anteo/zxevo.pentevo/cfgs/standalone_base_trdemu/trunk/README

make.sh uses avr/baseconf/trunk and fpga/base_trdemu/trunk from the repository.
FPGA_PATH, AVR_PATH and MHMT_BIN can be overridden through the environment.

On macOS, make.sh builds the host utilities using make before running the
original build sequence:

./cfgs/standalone_base_trdemu/trunk/make.sh

Для wsl:
Пересобрать mhmt и make_fw.

Для Windows:
скачать архив отсюда https://blog.zakkemble.net/avr-gcc-builds/
и распаковать.
В файле winbuild.bat исправить путь до 
папки bin из выше скаченного архива.
winbuild.bat не собирает исходники fpga, т.е. они должны быть
предварительно собраны.
