anteo/zxevo.pentevo/kicad/rev_d+/Sheet2.kicad_sch

## KiCad design kicad/rev_d+/Sheet2.kicad_sch (2026-09-26)

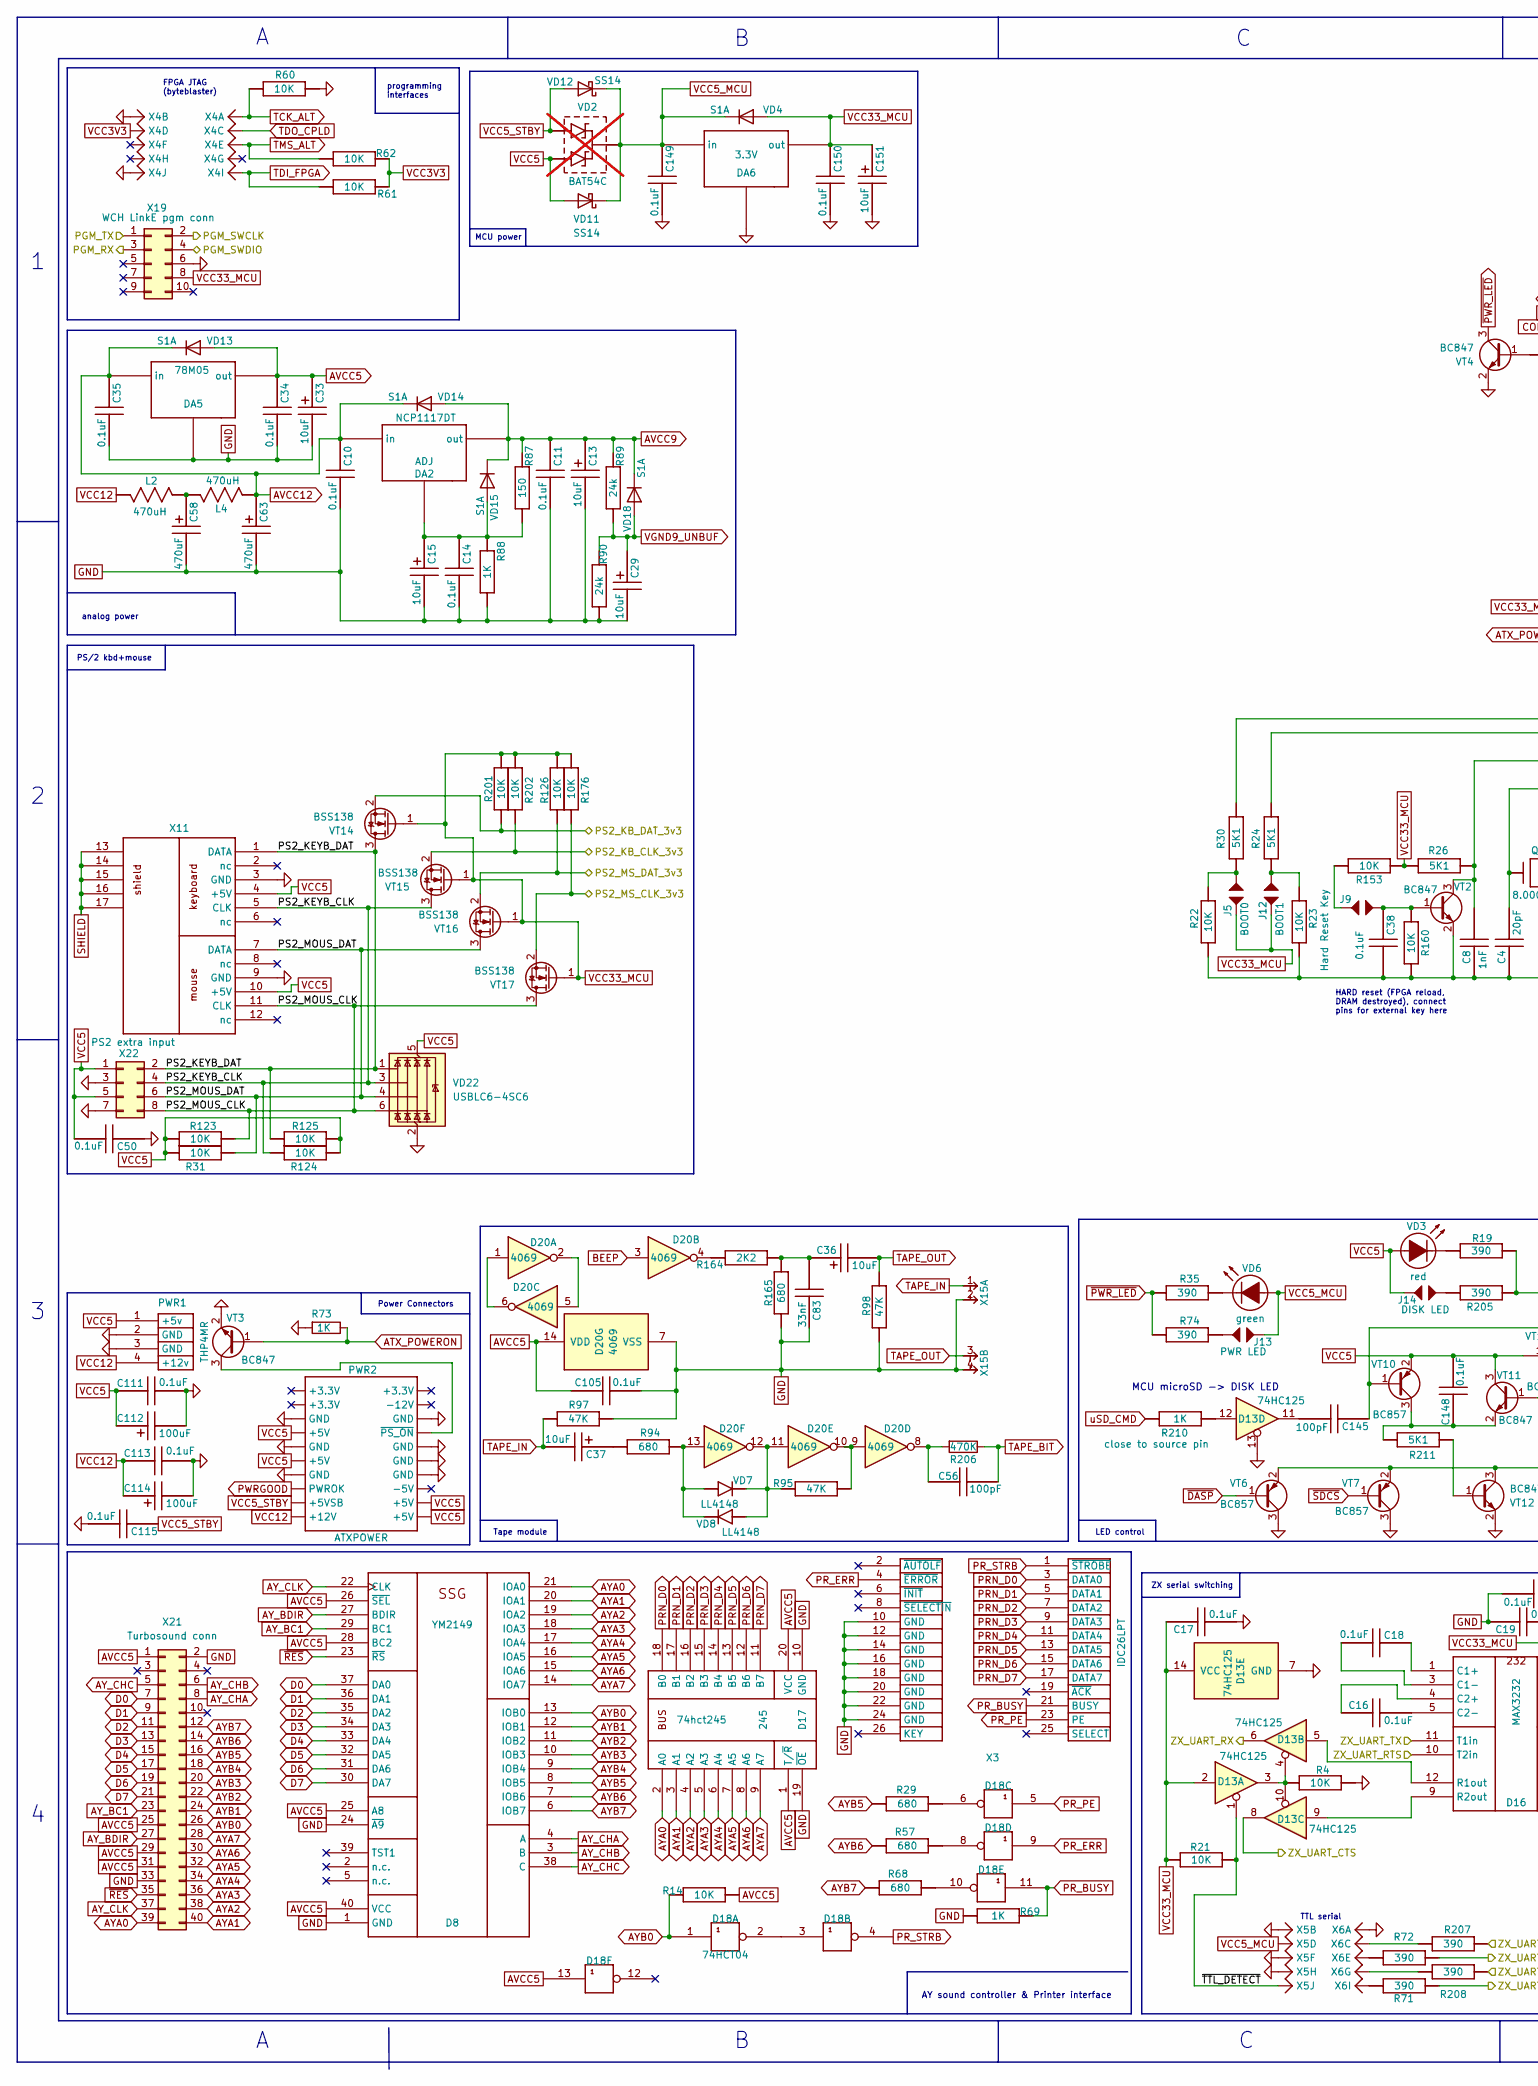
[picture p14: schematic Sheet2.kicad_sch, part in row 1, column 1]

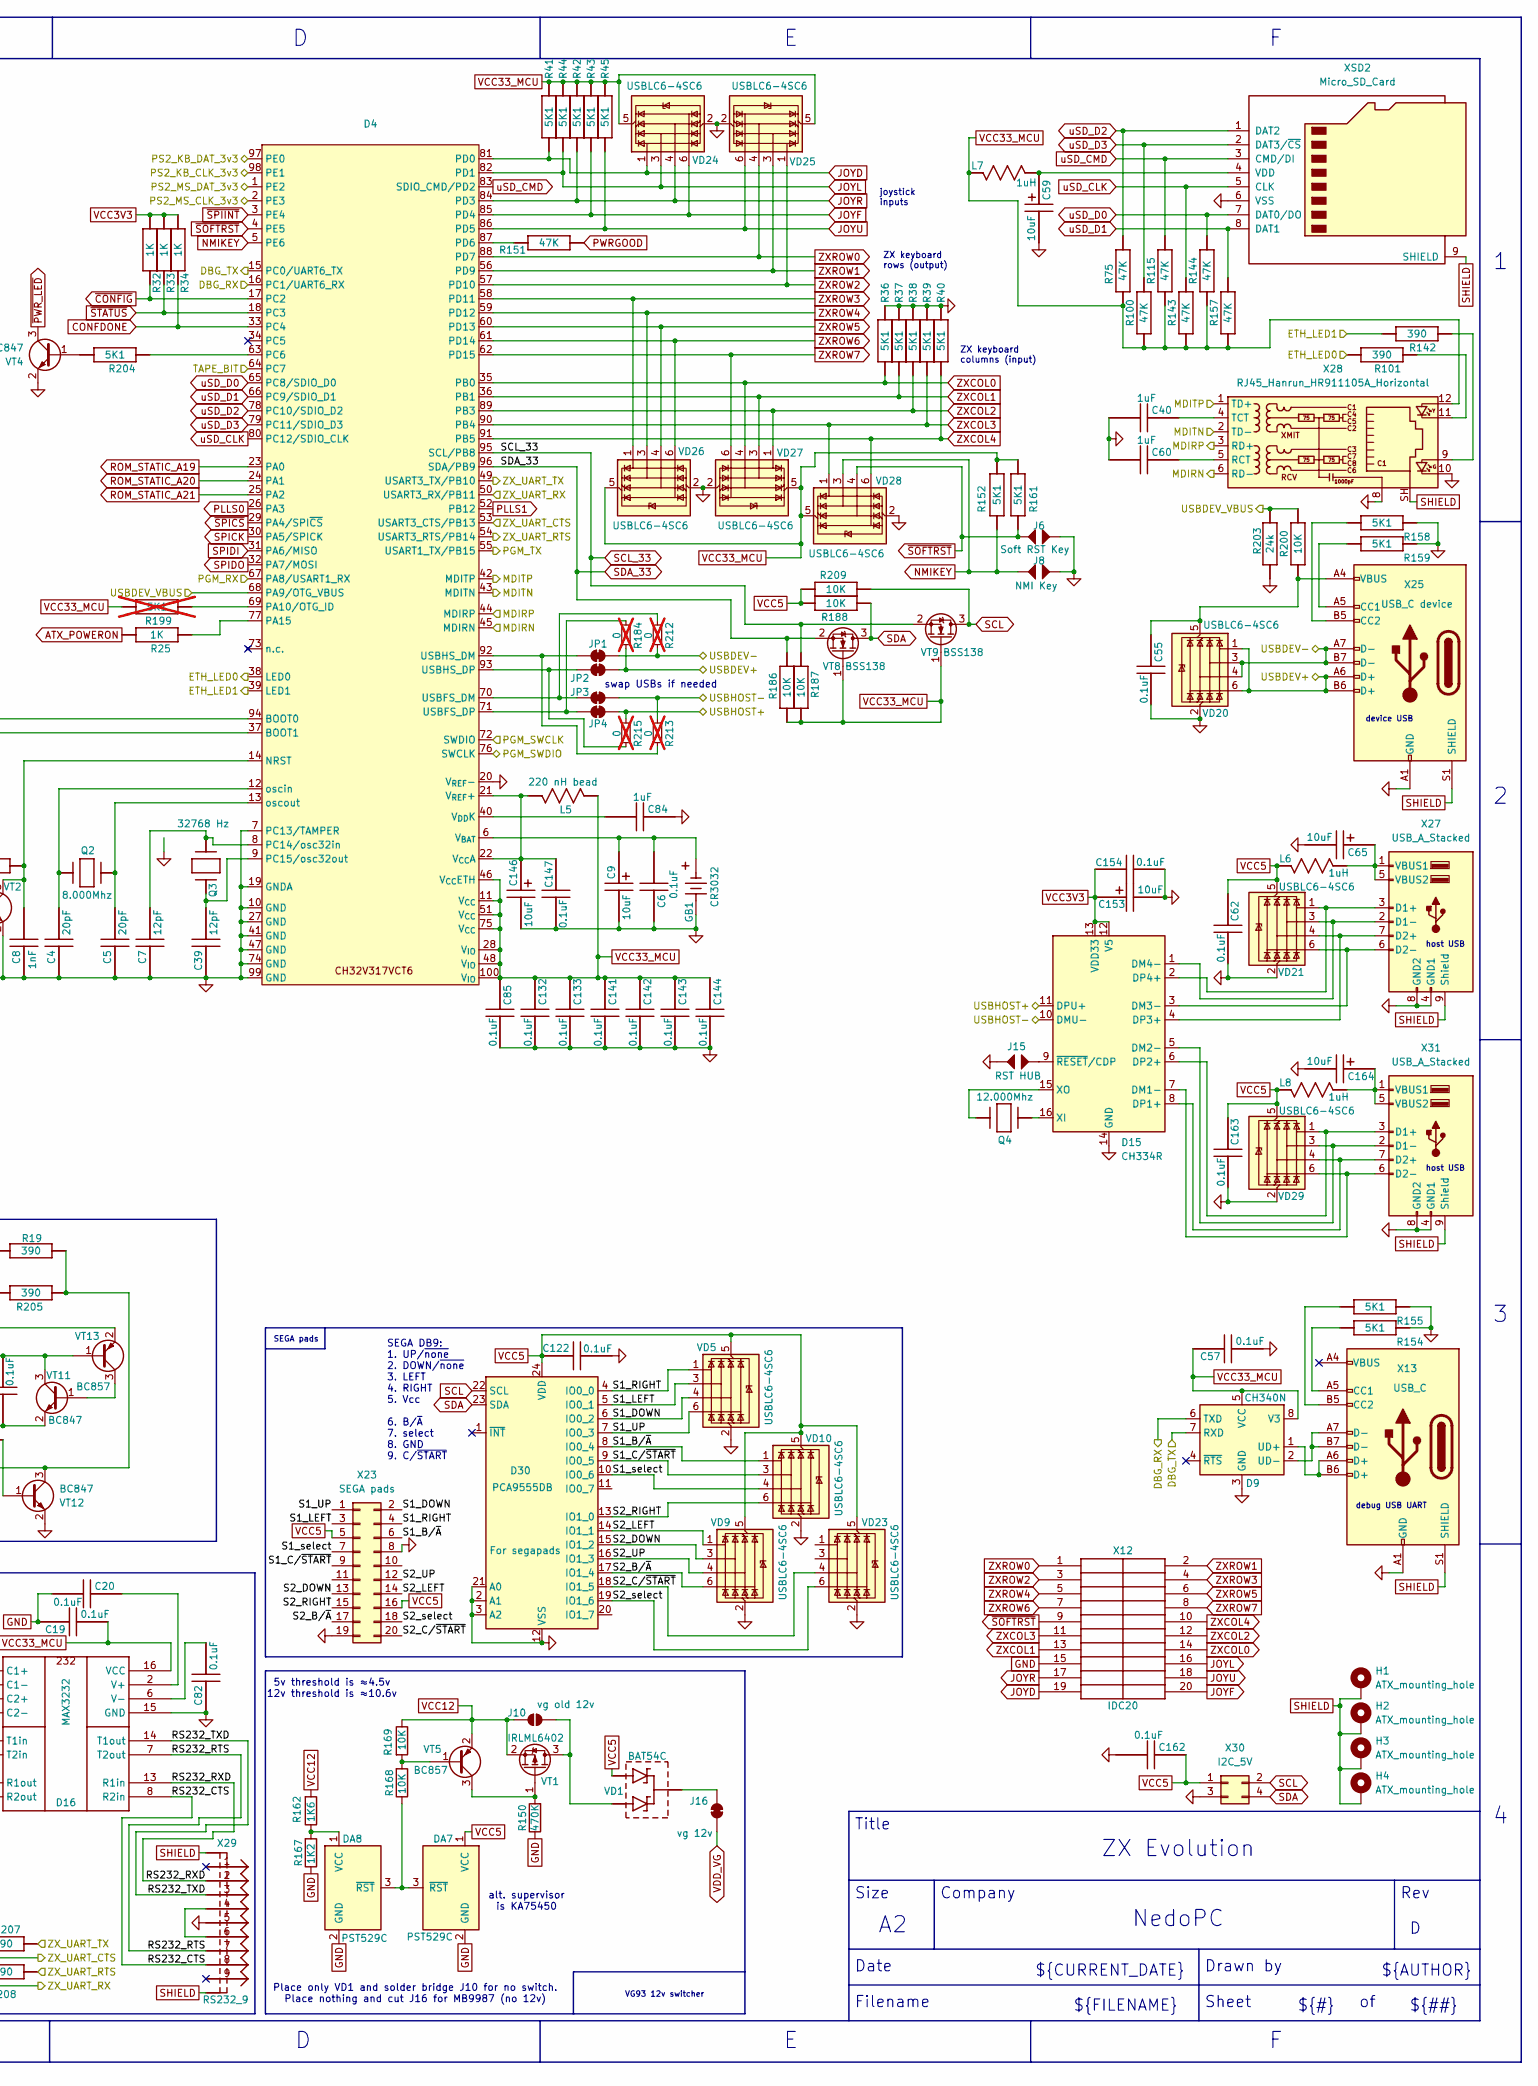
[picture p15: schematic Sheet2.kicad_sch, part in row 1, column 2]

Parts:
C4: 20pF; C_0805_2012Metric_Pad1.18x1.45mm_HandSolder
C5: 20pF; C-CHIP
C6, C10, C11, C14, C16, C17, C18, C19, C20, C34, C35, C38, C50, C55, C57, C62, C82, C85, C105, C111, C113, C115, C122, C132, C133, C141, C142, C143, C144, C147, C148, C149, C150, C154, C162, C163: 0.1uF; C-CHIP
C7, C39: 12pF; C-CHIP
C8: 1nF; C-CHIP
C9, C13, C15, C29, C33, C36, C37, C59, C65, C146, C151, C153, C164: 10uF; EC-CHIP
C40, C60, C84: 1uF; C-CHIP
C56: 100pF; C-CHIP
C58, C63: 470uF; CP_Radial_D10.0mm_P5.00mm
C83: 33nF; C-CHIP
C112, C114: 100uF; EC-CHIPB
C145: 100pF; C_0805_2012Metric_Pad1.18x1.45mm_HandSolder
D4: (no value)
D8: YM2149; DIP40
D9: CH340N; SOP-8_3.9x4.9mm_P1.27mm
D13: 74HC125
D15: CH334R; QSOP-16_3.9x4.9mm_P0.635mm
D16: MAX3232; SO16
D17: 245; TSSOP-20_4.4x6.5mm_P0.65mm
D18: 04; SO14
D20: 4069; SOIC-14_3.9x8.7mm_P1.27mm
D30: PCA9555DB; SSOP-24_5.3x8.2mm_P0.65mm
DA2: NCP1117DT; DPAK
DA5: 78M05; DPAK
DA6: 3.3V; DPAK
DA7, DA8: PST529C; TO-92_HandSolder
GB1: BAT
H1, H2, H3, H4: ATX_mounting_hole
J5, J6, J8, J9, J12, J13, J14, J15: JUMPER
J10: vg old 12v; SolderJumper-2_P1.3mm_Open_RoundedPad1.0x1.5mm
J16: vg 12v; SolderJumper-2_P1.3mm_Bridged_RoundedPad1.0x1.5mm
JP1, JP2, JP3, JP4: SolderJumper_2_Bridged
L2, L4: 470uH; L_Bourns_SRP6060FA
L5: 220 nH bead; L-CHIP
L6, L7, L8: 1uH; L-CHIP
PWR1: THP4MR; THP_4MR
PWR2: ATXPOWER
Q2, Q4: QUARTZ; CRYSTAL
Q3: QUARTZ32768; 32768
R4, R14, R21, R22, R23, R31, R60, R61, R62, R123, R124, R125, R126, R153, R160, R176, R186, R187, R188, R200, R201, R202, R209: 10K; R-CHIP
R19, R35, R71, R72, R74, R101, R142, R205, R207, R208: 390; R-CHIP
R24, R26, R30, R36, R37, R38, R39, R40, R41, R42, R43, R44, R45, R152, R154, R155, R158, R159, R161, R204, R211: 5K1; R-CHIP
R25, R32, R33, R34, R69, R88, R210: 1K; R-CHIP
R29, R57, R68, R94, R165: 680; R-CHIP
R73: 1K; R_0805_2012Metric_Pad1.20x1.40mm_HandSolder
R75, R95, R97, R98, R100, R115, R143, R144, R151, R157: 47K; R-CHIP
R87: 150; R-CHIP
R89, R90, R203: 24k; R-CHIP
R150, R206: 470K; R_0805_2012Metric_Pad1.20x1.40mm_HandSolder
R162: 1K6; R_0805_2012Metric_Pad1.20x1.40mm_HandSolder
R164: 2K2; R-CHIP
R167: 1K2; R_0805_2012Metric_Pad1.20x1.40mm_HandSolder
R168, R169: 10K; R_0805_2012Metric_Pad1.20x1.40mm_HandSolder
R184, R212, R213, R215: 0; R-CHIP; not fitted
R199: 5K1; R-CHIP; not fitted
VD1: BAT54C; SOT-23_Handsoldering
VD2: BAT54C; SOT-23; not fitted
VD3, VD6: LED; LED_0805_2012Metric_Pad1.15x1.40mm_HandSolder
VD4, VD13, VD14, VD15, VD18: S1A; D_SMA
VD5, VD9, VD10, VD20, VD21, VD22, VD23, VD24, VD25, VD26, VD27, VD28, VD29: USBLC6-4SC6; SOT-23-6
VD7, VD8: LL4148; D_MiniMELF_Handsoldering
VD11, VD12: SS14; D_SMA
VT1: IRLML6402; SOT-23_Handsoldering
VT2, VT3, VT4, VT11, VT12: BC847; SOT-23_Handsoldering
VT5, VT6, VT7, VT10, VT13: BC857; SOT-23_Handsoldering
VT8, VT9, VT14, VT15, VT16, VT17: BSS138; SOT-23
X3: IDC26LPT; IDC26
X4, X5, X6: IDC10M
X11: KEYB-MOUSE; MDD-6FR
X12: IDC20
X13: USB_C
X15: PLB2-2
X19: WCH LinkE pgm conn; IDC-Header_2x05_P2.54mm_Vertical
X21: Turbosound conn; IDC-Header_2x20_P2.54mm_Vertical
X22: PS2 extra input; PinSocket_2x04_P2.54mm_Vertical
X23: SEGA pads
X25: USB_C device
X27, X31: USB_A_Stacked
X28: RJ45_Hanrun_HR911105A_Horizontal
X29: RS232_9; DSUB-9
X30: I2C_5V
XSD2: Micro_SD_Card

Connections:
ATX_POWERON: R25.1 (i/o), R73.1, VT3.1 (B)
AVCC5: C33.1, C34.1, C105.1, D8.25 (A8), D8.26 (~SEL), D8.28 (BC2), D8.40 (VCC), D17.1 (T/~R), D17.20 (VCC), D18.13, D20.14 (VDD), DA5.3 (out), R14.1 (i/o), VD13.2 (A), X21.1, X21.25, X21.29, X21.31
AVCC9: C11.1, C13.1, DA2.2 (out), R87.2 (i/o1), R89.2 (i/o1), VD14.2 (A), VD15.1 (K), VD18.1 (K)
AVCC12: C10.1, C35.1, C63.1, DA2.3 (in), DA5.1 (in), L4.2, VD13.1 (K), VD14.1 (K)
AYA0: D8.21 (IOA0), D17.2 (A0), X21.39
AYA1: D8.20 (IOA1), D17.3 (A1), X21.40
AYA2: D8.19 (IOA2), D17.4 (A2), X21.38
AYA3: D8.18 (IOA3), D17.5 (A3), X21.36
AYA4: D8.17 (IOA4), D17.6 (A4), X21.34
AYA5: D8.16 (IOA5), D17.7 (A5), X21.32
AYA6: D8.15 (IOA6), D17.8 (A6), X21.30
AYA7: D8.14 (IOA7), D17.9 (A7), X21.28
AYB0: D8.13 (IOB0), D18.1, R14.2 (i/o1), X21.26
AYB1: D8.12 (IOB1), X21.24
AYB2: D8.11 (IOB2), X21.22
AYB3: D8.10 (IOB3), X21.20
AYB4: D8.9 (IOB4), X21.18
AYB5: D8.8 (IOB5), R29.2 (i/o1), X21.16
AYB6: D8.7 (IOB6), R57.2 (i/o1), X21.14
AYB7: D8.6 (IOB7), R68.2 (i/o1), X21.12
AY_BC1: D8.29 (BC1), X21.23
AY_BDIR: D8.27 (BDIR), X21.27
AY_CHA: D8.4 (A), X21.8
AY_CHB: D8.3 (B), X21.6
AY_CHC: D8.38 (C), X21.5
AY_CLK: D8.22 (CLK), X21.37
BEEP: D20.3
CONFDONE: D4.33 (PC4), R34.2 (i/o1)
D0: D8.37 (DA0), X21.7
D1: D8.36 (DA1), X21.9
D2: D8.35 (DA2), X21.11
D3: D8.34 (DA3), X21.13
D4: D8.33 (DA4), X21.15
D5: D8.32 (DA5), X21.17
D6: D8.31 (DA6), X21.19
D7: D8.30 (DA7), X21.21
DBG_RX: D4.16 (PC1/UART6_RX), D9.6 (TXD)
DBG_TX: D4.15 (PC0/UART6_TX), D9.7 (RXD)
ETH_LED0: D4.38 (LED0), R101.1 (i/o)
ETH_LED1: D4.39 (LED1), R142.1 (i/o)
GND: C4.1, C5.1, C6.1, C7.1, C8.1, C9.2, C10.2, C11.2, C13.2, C14.2, C15.2, C17.2, C19.1, C20.2, C29.2, C33.2, C34.2, C35.2, C38.2, C39.1, C40.2, C50.1, C55.2, C57.2, C58.2, C59.2, C60.2, C62.2, C63.2, C65.2, C82.1, C83.1, C84.1, C85.2, C105.2, C111.2, C112.2, C113.2, C114.2, C115.2, C122.2, C132.2, C133.2, C141.2, C142.2, C143.2, C144.2, C146.2, C147.1, C149.2, C150.2, C151.2, C153.2, C154.2, C162.2, C163.2, C164.2, D4.7 (PC13/TAMPER), D4.10 (GND), D4.19 (GNDA), D4.20 (V_{REF}-), D4.27 (GND), D4.41 (GND), D4.47 (GND), D4.74 (GND), D4.99 (GND), D8.1 (GND), D8.24 (~A9), D9.3 (GND), D13.7 (GND), D13.13, D15.14 (GND), D16.15 (GND), D17.10 (GND), D17.19 (~OE), D20.7 (VSS), D30.2 (A1), D30.3 (A2), D30.12 (VSS), D30.21 (A0), DA5.2, DA6.1, DA7.2 (GND), DA8.2 (GND), GB1.2 (MINUS), J6.1 (2), J8.1 (2), J15.1 (2), PWR1.2 (GND), PWR1.3 (GND), PWR2.3 (GND), PWR2.5 (GND), PWR2.7 (GND), PWR2.13 (GND), PWR2.15 (GND), PWR2.16 (GND), PWR2.17 (GND), Q3.3 (GND), R4.1 (i/o), R22.2 (i/o1), R23.2 (i/o1), R36.1 (i/o), R37.1 (i/o), R38.1 (i/o), R39.1 (i/o), R40.1 (i/o), R60.2 (i/o1), R69.1 (i/o), R73.2, R88.1 (i/o), R90.1 (i/o), R97.1 (i/o), R98.1 (i/o), R150.1, R154.2 (i/o1), R155.2 (i/o1), R158.2 (i/o1), R159.2 (i/o1), R160.2 (i/o1), R165.2 (i/o1), R167.1, R203.1 (i/o), VD5.2 (GND), VD9.2 (GND), VD10.2 (GND), VD20.2 (GND), VD21.2 (GND), VD22.2 (GND), VD23.2 (GND), VD24.2 (GND), VD25.2 (GND), VD26.2 (GND), VD27.2 (GND), VD28.2 (GND), VD29.2 (GND), VT2.2 (E), VT3.2 (E), VT4.2 (E), VT6.3 (C), VT7.3 (C), VT12.2 (E), X3.10 (GND), X3.12 (GND), X3.14 (GND), X3.16 (GND), X3.18 (GND), X3.20 (GND), X3.22 (GND), X3.24 (GND), X4.2, X4.10, X5.2, X5.6, X5.8, X6.1, X11.3 (GND), X11.9 (GND), X12.15, X13.A1 (GND), X13.A12 (GND), X13.B1 (GND), X13.B12 (GND), X15.2, X15.4 (2), X19.6, X21.2, X21.33, X22.3, X22.7, X23.8, X23.19, X25.A1 (GND), X25.A12 (GND), X25.B1 (GND), X25.B12 (GND), X27.4 (GND1), X27.8 (GND2), X28.8, X28.10, X29.5, X30.3, X31.4 (GND1), X31.8 (GND2), XSD2.6 (VSS)
JOYD: D4.81 (PD0), R41.2 (i/o1), VD24.1 (I/O1), X12.19
JOYF: D4.85 (PD4), R43.2 (i/o1), VD24.6 (I/O4), X12.20
JOYL: D4.82 (PD1), R44.2 (i/o1), VD24.3 (I/O2), X12.16
JOYR: D4.84 (PD3), R42.2 (i/o1), VD24.4 (I/O3), X12.17
JOYU: D4.86 (PD5), R45.2 (i/o1), VD25.6 (I/O4), X12.18
MDIRN: D4.45 (MDIRN), X28.6 (RD-)
MDIRP: D4.44 (MDIRP), X28.3 (RD+)
MDITN: D4.43 (MDITN), X28.2 (TD-)
MDITP: D4.42 (MDITP), X28.1 (TD+)
NMIKEY: D4.5 (PE6), J8.0 (1), R152.2 (i/o1), VD28.3 (I/O2)
unnamed: C4.2, D4.12 (oscin), Q2.A
unnamed: C5.2, D4.13 (oscout), Q2.B
unnamed: C6.2, C9.1, D4.6 (V_{BAT}), GB1.1 (PLUS)
unnamed: C7.2, D4.8 (PC14/osc32in), Q3.2
unnamed: C8.2, D4.14 (NRST), R26.1 (i/o), VT2.3 (C)
unnamed: C14.1, C15.1, DA2.1, R87.1 (i/o), R88.2 (i/o1), VD15.2 (A)
unnamed: C16.1, D16.4 (C2+)
unnamed: C16.2, D16.5 (C2-)
unnamed: C18.1, D16.1 (C1+)
unnamed: C18.2, D16.3 (C1-)
unnamed: C20.1, D16.2 (V+)
unnamed: C36.1, C83.2, R164.1 (i/o), R165.1 (i/o)
unnamed: C37.1, R94.2 (i/o1)
unnamed: C38.1, J9.0 (1), R160.1 (i/o), VT2.1 (B)
unnamed: C39.2, D4.9 (PC15/osc32out), Q3.1
unnamed: C40.1, X28.4 (TCT)
unnamed: C55.1, R200.1 (i/o), VD20.5 (VBUS), X25.A4 (VBUS), X25.A9 (VBUS), X25.B4 (VBUS), X25.B9 (VBUS)
unnamed: C56.1, D20.8, R206.2
unnamed: C58.1, L2.1, L4.1
unnamed: C59.1, L7.2, XSD2.4 (VDD)
unnamed: C60.1, X28.5 (RCT)
unnamed: C65.1, L6.2, X27.1 (VBUS1), X27.5 (VBUS2)
unnamed: C82.2, D16.6 (V-)
unnamed: C84.2, D4.40 (V_{DD}K)
unnamed: C145.1, VT10.1 (B), VT13.2 (E)
unnamed: C145.2, D13.11
unnamed: C146.1, C147.2, D4.21 (V_{REF}+), D4.22 (V_{CC}A), L5.1
unnamed: C148.1, R211.1 (i/o), VT10.3 (C), VT11.2 (E)
unnamed: C164.1, L8.2, X31.1 (VBUS1), X31.5 (VBUS2)
unnamed: D4.37 (BOOT1), R24.1 (i/o)
unnamed: D4.63 (PC6), R204.2 (i/o1)
unnamed: D4.69 (PA10/OTG_ID), R199.2 (i/o1)
unnamed: D4.70 (USBFS_DM), JP3.1 (A), R212.1
unnamed: D4.71 (USBFS_DP), JP4.1 (A), R184.1
unnamed: D4.77 (PA15), R25.2 (i/o1)
unnamed: D4.87 (PD6), R151.1 (i/o)
unnamed: D4.92 (USBHS_DM), JP1.1 (A), R213.2
unnamed: D4.93 (USBHS_DP), JP2.1 (A), R215.2
unnamed: D4.94 (BOOT0), R30.1 (i/o)
unnamed: D9.1 (UD+), X13.A6 (D+), X13.B6 (D+)
unnamed: D9.2 (UD-), X13.A7 (D-), X13.B7 (D-)
unnamed: D13.5, D16.12 (R1out)
unnamed: D13.9, D16.9 (R2out)
unnamed: D13.3, D13.4, D13.10, R4.2 (i/o1)
unnamed: D13.12, R210.1 (i/o)
unnamed: D15.1 (DM4-), VD21.3 (I/O2), X27.2 (D1-)
unnamed: D15.2 (DP4+), VD21.1 (I/O1), X27.3 (D1+)
unnamed: D15.3 (DM3-), VD21.6 (I/O4), X27.6 (D2-)
unnamed: D15.4 (DP3+), VD21.4 (I/O3), X27.7 (D2+)
unnamed: D15.5 (DM2-), VD29.3 (I/O2), X31.2 (D1-)
unnamed: D15.6 (DP2+), VD29.1 (I/O1), X31.3 (D1+)
unnamed: D15.7 (DM1-), VD29.6 (I/O4), X31.6 (D2-)
unnamed: D15.8 (DP1+), VD29.4 (I/O3), X31.7 (D2+)
unnamed: D15.9 (~RESET/CDP), J15.0 (1)
unnamed: D15.15 (XO), Q4.A
unnamed: D15.16 (XI), Q4.B
unnamed: D18.2, D18.3
unnamed: D18.6, R29.1 (i/o)
unnamed: D18.8, R57.1 (i/o)
unnamed: D18.10, R68.1 (i/o)
unnamed: D20.1, D20.6
unnamed: D20.2, D20.5
unnamed: D20.4, R164.2 (i/o1)
unnamed: D20.9, D20.10, R95.1 (i/o)
unnamed: D20.11, D20.12, R95.2 (i/o1), VD7.2 (C), VD8.1 (A)
unnamed: D20.13, R94.1 (i/o), VD7.1 (A), VD8.2 (C)
unnamed: DA7.3 (~RST), DA8.3 (~RST), R168.1
unnamed: DA8.1 (VCC), R162.1, R167.2
unnamed: J5.0 (1), R22.1 (i/o), R30.2 (i/o1)
unnamed: J9.1 (2), R153.2 (i/o1)
unnamed: J10.1 (A), VD1.2, VT1.3 (D)
unnamed: J12.0 (1), R23.1 (i/o), R24.2 (i/o1)
unnamed: J13.1 (2), R74.2 (i/o1)
unnamed: J14.0 (1), R205.1 (i/o)
unnamed: J16.2 (B), VD1.3
unnamed: PWR2.14 (~PS_ON), VT3.3 (C)
unnamed: R19.1 (i/o), VD3.K
unnamed: R19.2 (i/o1), R205.2 (i/o1), VT6.2 (E), VT7.2 (E), VT12.3 (C)
unnamed: R35.2 (i/o1), VD6.K
unnamed: R71.1 (i/o), X6.9
unnamed: R72.1 (i/o), X6.5
unnamed: R101.2 (i/o1), X28.11
unnamed: R142.2 (i/o1), X28.9
unnamed: R150.2, VT1.1 (G), VT5.3 (C)
unnamed: R154.1 (i/o), X13.A5 (CC1)
unnamed: R155.1 (i/o), X13.B5 (CC2)
unnamed: R158.1 (i/o), X25.B5 (CC2)
unnamed: R159.1 (i/o), X25.A5 (CC1)
unnamed: R168.2, R169.2, VT5.1 (B)
unnamed: R204.1 (i/o), VT4.1 (B)
unnamed: R207.2 (i/o1), X6.3
unnamed: R208.1 (i/o), X6.7
unnamed: R211.2 (i/o1), VT12.1 (B)
unnamed: VT11.1 (B), VT13.3 (C)
unnamed: X13.A4 (VBUS), X13.A9 (VBUS), X13.B4 (VBUS), X13.B9 (VBUS)
unnamed: X29.4, X29.6
PGM_RX: D4.67 (PA8/USART1_RX), X19.3
PGM_SWCLK: D4.72 (SWDIO), X19.2
PGM_SWDIO: D4.76 (SWCLK), X19.4
PGM_TX: D4.55 (USART1_TX/PB15), X19.1
PLLS0: D4.26 (PA3)
PLLS1: D4.52 (PB12)
PRN_D0: D17.18 (B0), X3.3 (DATA0)
PRN_D1: D17.17 (B1), X3.5 (DATA1)
PRN_D2: D17.16 (B2), X3.7 (DATA2)
PRN_D3: D17.15 (B3), X3.9 (DATA3)
PRN_D4: D17.14 (B4), X3.11 (DATA4)
PRN_D5: D17.13 (B5), X3.13 (DATA5)
PRN_D6: D17.12 (B6), X3.15 (DATA6)
PRN_D7: D17.11 (B7), X3.17 (DATA7)
PR_BUSY: D18.11, R69.2 (i/o1), X3.21 (BUSY)
PR_ERR: D18.9, X3.4 (~ERROR)
PR_PE: D18.5, X3.23 (PE)
PR_STRB: D18.4, X3.1 (~STROBE)
PS2_KB_CLK_3v3: D4.98 (PE1), R202.1 (i/o), VT15.2 (S)
PS2_KB_DAT_3v3: D4.97 (PE0), R201.1 (i/o), VT14.2 (S)
PS2_KEYB_CLK: R124.1 (i/o), VD22.3 (I/O2), VT15.3 (D), X11.5 (CLK), X22.4
PS2_KEYB_DAT: R125.1 (i/o), VD22.1 (I/O1), VT14.3 (D), X11.1 (DATA), X22.2
PS2_MOUS_CLK: R123.2 (i/o1), VD22.6 (I/O4), VT17.3 (D), X11.11 (CLK), X22.8
PS2_MOUS_DAT: R31.2 (i/o1), VD22.4 (I/O3), VT16.3 (D), X11.7 (DATA), X22.6
PS2_MS_CLK_3v3: D4.2 (PE3), R176.1 (i/o), VT17.2 (S)
PS2_MS_DAT_3v3: D4.1 (PE2), R126.1 (i/o), VT16.2 (S)
PWRGOOD: PWR2.8 (PWROK), R151.2 (i/o1)
ROM_STATIC_A19: D4.23 (PA0)
ROM_STATIC_A20: D4.24 (PA1)
ROM_STATIC_A21: D4.25 (PA2)
RS232_CTS: D16.8 (R2in), X29.8
RS232_RTS: D16.7 (T2out), X29.7
RS232_RXD: D16.13 (R1in), X29.2
RS232_TXD: D16.14 (T1out), X29.3
S1_B/~A: D30.8 (IO0_4), VD10.1 (I/O1), X23.6
S1_C/~START: D30.9 (IO0_5), VD10.3 (I/O2), X23.9
S1_DOWN: D30.6 (IO0_2), VD5.4 (I/O3), X23.2
S1_LEFT: D30.5 (IO0_1), VD5.3 (I/O2), X23.3
S1_RIGHT: D30.4 (IO0_0), VD5.1 (I/O1), X23.4
S1_UP: D30.7 (IO0_3), VD5.6 (I/O4), X23.1
S1_select: D30.10 (IO0_6), VD10.4 (I/O3), X23.7
S2_B/~A: D30.17 (IO1_4), VD9.6 (I/O4), X23.17
S2_C/~START: D30.18 (IO1_5), VD23.4 (I/O3), X23.20
S2_DOWN: D30.15 (IO1_2), VD9.3 (I/O2), X23.13
S2_LEFT: D30.14 (IO1_1), VD9.1 (I/O1), X23.14
S2_RIGHT: D30.13 (IO1_0), VD10.6 (I/O4), X23.15
S2_UP: D30.16 (IO1_3), VD9.4 (I/O3), X23.12
S2_select: D30.19 (IO1_6), VD23.6 (I/O4), X23.18
SCL: D30.22 (SCL), R209.2 (i/o1), VT9.3 (D), X30.2
SCL_33: D4.95 (SCL/PB8), R187.1 (i/o), VT9.2 (S)
SDA: D30.23 (SDA), R188.2 (i/o1), VT8.3 (D), X30.4
SDA_33: D4.96 (SDA/PB9), R186.1 (i/o), VT8.2 (S)
SHIELD: H1.1, H2.1, H3.1, H4.1, X11.13 (shield), X11.14 (shield), X11.15 (shield), X11.16 (shield), X11.17 (shield), X13.S1 (SHIELD), X25.S1 (SHIELD), X27.9 (Shield), X28.SH, X29.10, X29.11, X31.9 (Shield), XSD2.9 (SHIELD)
SPICK: D4.30 (PA5/SPICK)
SPIDI: D4.31 (PA6/MISO)
SPIDO: D4.32 (PA7/MOSI)
TAPE_BIT: C56.2, D4.64 (PC7), R206.1
TAPE_IN: C37.2, R97.2 (i/o1), X15.1
TAPE_OUT: C36.2, R98.2 (i/o1), X15.3 (1)
TCK_ALT: R60.1 (i/o), X4.1
TDI_FPGA: R61.1 (i/o), X4.9
TDO_CPLD: X4.3
TMS_ALT: R62.1 (i/o), X4.5
USBDEV+: JP2.2 (B), R184.2, VD20.1 (I/O1), VD20.6 (I/O4), X25.A6 (D+), X25.B6 (D+)
USBDEV-: JP1.2 (B), R212.2, VD20.3 (I/O2), VD20.4 (I/O3), X25.A7 (D-), X25.B7 (D-)
USBDEV_VBUS: D4.68 (PA9/OTG_VBUS), R200.2 (i/o1), R203.2 (i/o1)
USBHOST+: D15.11 (DPU+), JP4.2 (B), R215.1
USBHOST-: D15.10 (DMU-), JP3.2 (B), R213.1
VCC3V3: C153.1, C154.1, D15.12 (V5), D15.13 (VDD33_{LDO}), R32.1 (i/o), R33.1 (i/o), R34.1 (i/o), R61.2 (i/o1), R62.2 (i/o1), X4.4
VCC5: C50.2, C62.1, C111.1, C112.1, C122.1, C148.2, C162.1, C163.1, D30.24 (VDD), DA7.1 (VCC), J14.1 (2), L6.1, L8.1, PWR1.1 (+5v), PWR2.4 (+5V), PWR2.6 (+5V), PWR2.19 (+5V), PWR2.20 (+5V), R31.1 (i/o), R123.1 (i/o), R124.2 (i/o1), R125.2 (i/o1), R188.1 (i/o), R209.1 (i/o), VD1.1, VD2.2, VD3.A, VD5.5 (VBUS), VD9.5 (VBUS), VD10.5 (VBUS), VD11.2 (A), VD21.5 (VBUS), VD22.5 (VBUS), VD23.5 (VBUS), VD29.5 (VBUS), VT10.2 (E), VT11.3 (C), VT13.1 (B), X11.4 (+5V), X11.10 (+5V), X22.1, X22.5, X23.5, X23.16, X30.1
VCC5_MCU: C149.1, DA6.3 (in), J13.0 (1), VD2.3, VD4.1 (K), VD6.A, VD11.1 (K), VD12.1 (K), X5.4
VCC5_STBY: C115.1, PWR2.9 (+5VSB), VD2.1, VD12.2 (A)
VCC12: C113.1, C114.1, J10.2 (B), L2.2, PWR1.4 (+12v), PWR2.10 (+12V), R162.2, R169.1, VT1.2 (S), VT5.2 (E)
VCC33_MCU: C17.1, C19.2, C57.1, C85.1, C132.1, C133.1, C141.1, C142.1, C143.1, C144.1, C150.1, C151.1, D4.11 (V_{CC}), D4.28 (V_{IO}), D4.46 (V_{CC}ETH), D4.48 (V_{IO}), D4.51 (V_{CC}), D4.75 (V_{CC}), D4.100 (V_{IO}), D9.5 (VCC), D9.8 (V3), D13.2, D13.14 (VCC), D16.16 (VCC), DA6.2 (out), J5.1 (2), J12.1 (2), L5.2, L7.1, R21.2 (i/o1), R26.2 (i/o1), R41.1 (i/o), R42.1 (i/o), R43.1 (i/o), R44.1 (i/o), R45.1 (i/o), R75.1 (i/o), R100.1 (i/o), R115.1 (i/o), R126.2 (i/o1), R143.1 (i/o), R144.1 (i/o), R152.1 (i/o), R153.1 (i/o), R157.1 (i/o), R161.1 (i/o), R176.2 (i/o1), R186.2 (i/o1), R187.2 (i/o1), R199.1 (i/o), R201.2 (i/o1), R202.2 (i/o1), VD4.2 (A), VD24.5 (VBUS), VD25.5 (VBUS), VD26.5 (VBUS), VD27.5 (VBUS), VD28.5 (VBUS), VT8.1 (G), VT9.1 (G), VT14.1 (G), VT15.1 (G), VT16.1 (G), VT17.1 (G), X19.8, X28.12
VDD_VG: J16.1 (A)
VGND9_UNBUF: C29.1, R89.1 (i/o), R90.2 (i/o1), VD18.2 (A)
ZXCOL0: D4.35 (PB0), R36.2 (i/o1), VD27.4 (I/O3), X12.14
ZXCOL1: D4.36 (PB1), R37.2 (i/o1), VD27.3 (I/O2), X12.13
ZXCOL2: D4.89 (PB3), R38.2 (i/o1), VD27.1 (I/O1), X12.12
ZXCOL3: D4.90 (PB4), R39.2 (i/o1), VD28.1 (I/O1), X12.11
ZXCOL4: D4.91 (PB5), R40.2 (i/o1), VD28.6 (I/O4), X12.10
ZXROW0: D4.88 (PD7), VD25.4 (I/O3), X12.1
ZXROW1: D4.56 (PD9), VD25.3 (I/O2), X12.2
ZXROW2: D4.57 (PD10), VD25.1 (I/O1), X12.3
ZXROW3: D4.58 (PD11), VD26.1 (I/O1), X12.4
ZXROW4: D4.59 (PD12), VD26.3 (I/O2), X12.5
ZXROW5: D4.60 (PD13), VD26.4 (I/O3), X12.6
ZXROW6: D4.61 (PD14), VD26.6 (I/O4), X12.7
ZXROW7: D4.62 (PD15), VD27.6 (I/O4), X12.8
ZX_UART_CTS: D4.53 (USART3_CTS/PB13), D13.8, R72.2 (i/o1)
ZX_UART_RTS: D4.54 (USART3_RTS/PB14), D16.10 (T2in), R208.2 (i/o1)
ZX_UART_RX: D4.50 (USART3_RX/PB11), D13.6, R71.2 (i/o1)
ZX_UART_TX: D4.49 (USART3_TX/PB10), D16.11 (T1in), R207.1 (i/o)
uSD_CLK: D4.80 (PC12/SDIO_CLK), R143.2 (i/o1), XSD2.5 (CLK)
uSD_CMD: D4.83 (SDIO_CMD/PD2), R115.2 (i/o1), R210.2 (i/o1), XSD2.3 (CMD/DI)
uSD_D0: D4.65 (PC8/SDIO_D0), R144.2 (i/o1), XSD2.7 (DAT0/DO)
uSD_D1: D4.66 (PC9/SDIO_D1), R157.2 (i/o1), XSD2.8 (DAT1)
uSD_D2: D4.78 (PC10/SDIO_D2), R75.2 (i/o1), XSD2.1 (DAT2)
uSD_D3: D4.79 (PC11/SDIO_D3), R100.2 (i/o1), XSD2.2 (DAT3/~CS)
~CONFIG: D4.17 (PC2), R32.2 (i/o1)
~DASP: VT6.1 (B)
~PWR_LED: R35.1 (i/o), R74.1 (i/o), VT4.3 (C)
~RES: D8.23 (~RS), X21.35
~SDCS: VT7.1 (B)
~SOFTRST: D4.4 (PE5), J6.0 (1), R161.2 (i/o1), VD28.4 (I/O3), X12.9
~SPICS: D4.29 (PA4/SPI~CS)
~SPIINT: D4.3 (PE4)
~STATUS: D4.18 (PC3), R33.2 (i/o1)
~TTL_DETECT: D13.1, R21.1 (i/o), X5.10

Notes on the sheet:
Power Connectors
${FILENAME}
SEGA pads
Sheet
LED control
host USB
Size
analog power
device USB
${AUTHOR}
Tape module
${COMPANY}
VG93 12v switcher
Filename
alt. supervisor is KA75450
${CURRENT_DATE}
swap USBs if needed
Drawn by
Date
5v threshold is ≈4.5v 12v threshold is ≈10.6v
Rev
Place only VD1 and solder bridge J10 for no switch. Place nothing and cut J16 for MB9987 (no 12v)
MCU power
Title
AY sound controller & Printer interface
MCU microSD -> DISK LED
${TITLE}
debug USB UART
Company
${REVISION}
${##}
${#}
ZX serial switching
SEGA DB9: 1. UP/~{none} 2. DOWN/~{none} 3. LEFT 4. RIGHT 5. Vcc 6. B/~{A} 7. select 8. GND 9. C/~{START}
PS/2 kbd+mouse
joystick inputs
HARD reset (FPGA reload, DRAM destroyed), connect pins for external key here
ZX keyboard rows (output)
TTL serial
ZX keyboard columns (input)
programming interfaces
FPGA JTAG (byteblaster)
