anteo/zxevo.pentevo/(commit log)

2026-09-12 ERS 0.61.01: - исправлена порча рамдиска при отображение информации на главном экране. - добавлена возможность перебора режимов автозапуска мышью. - удалена сборка и собранный ROM zx_evo.rom. - добав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
2026-09-12 Исправлен обновлятор прошивки, перезаливка собранного рома.
2026-09-25 pentevo: rev D+: swap HS and FS USBs: FS now is host, HS now is device
    [Sheet2.kicad_sch]
2026-09-26 pentevo: rev D+: change HUB to CH334, add possibility to swap USBs back (cuts + 0 Ohm resistors)
    [Sheet2.kicad_sch, eva.kicad_sch]
2026-11-06 fix(ers): honor the AY printer setting
2026-11-06 fix(ers): preserve the caller on screen printing
2026-11-06 fix(ers): correct ZX window printing and scrolling
